patrickdcp77/lora-module-htcc-ab02/documentation/pcb_polyvalent_promini ou heltec_solaire_1bal_ds18b20_dht22/pcb_polyvalent_solaire_1bal_ds18b20_dht22 bis.png

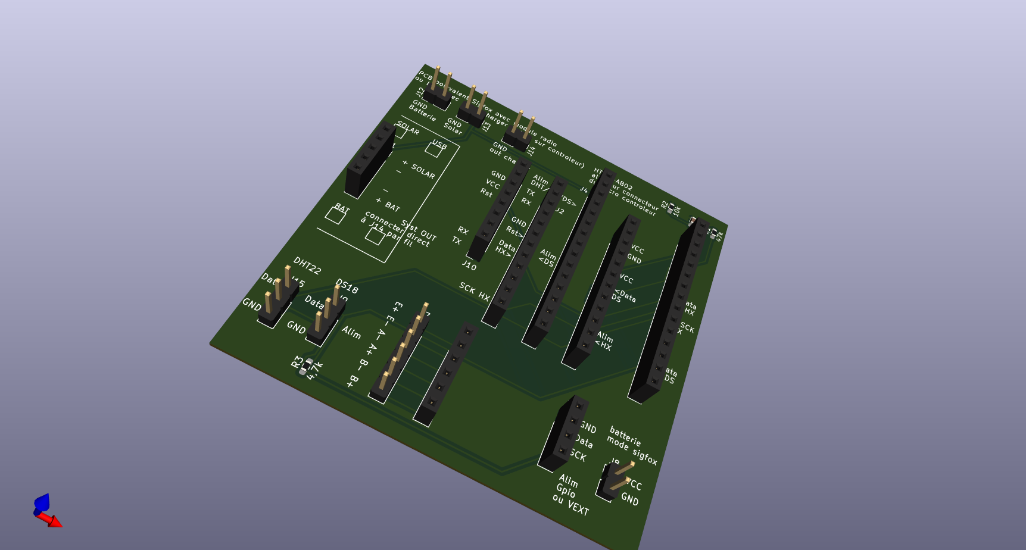
documentation/pcb_polyvalent_promini ou heltec_solaire_1bal_ds18b20_dht22/pcb_polyvalent_solaire_1bal_ds18b20_dht22 bis.png
