patrickdcp77/lora-module-htcc-ab02/(list of files, drawings)

Other design files:
documentation/pcb_polyvalent_promini ou heltec_solaire_1bal_ds18b20_dht22/pcb_polyvalent_solaire_1bal_ds18b20_dht22.dsn
