patrickdcp77/lora-module-htcc-ab02/documentation/pcb_polyvalent_promini ou heltec_solaire_1bal_ds18b20_dht22/pcb_polyvalent_solaire_1bal_ds18b20_dht22.kicad_pcb

## KiCad design documentation/pcb_polyvalent_promini ou heltec_solaire_1bal_ds18b20_dht22/pcb_polyvalent_solaire_1bal_ds18b20_dht22.kicad_pcb (2024-09-22)

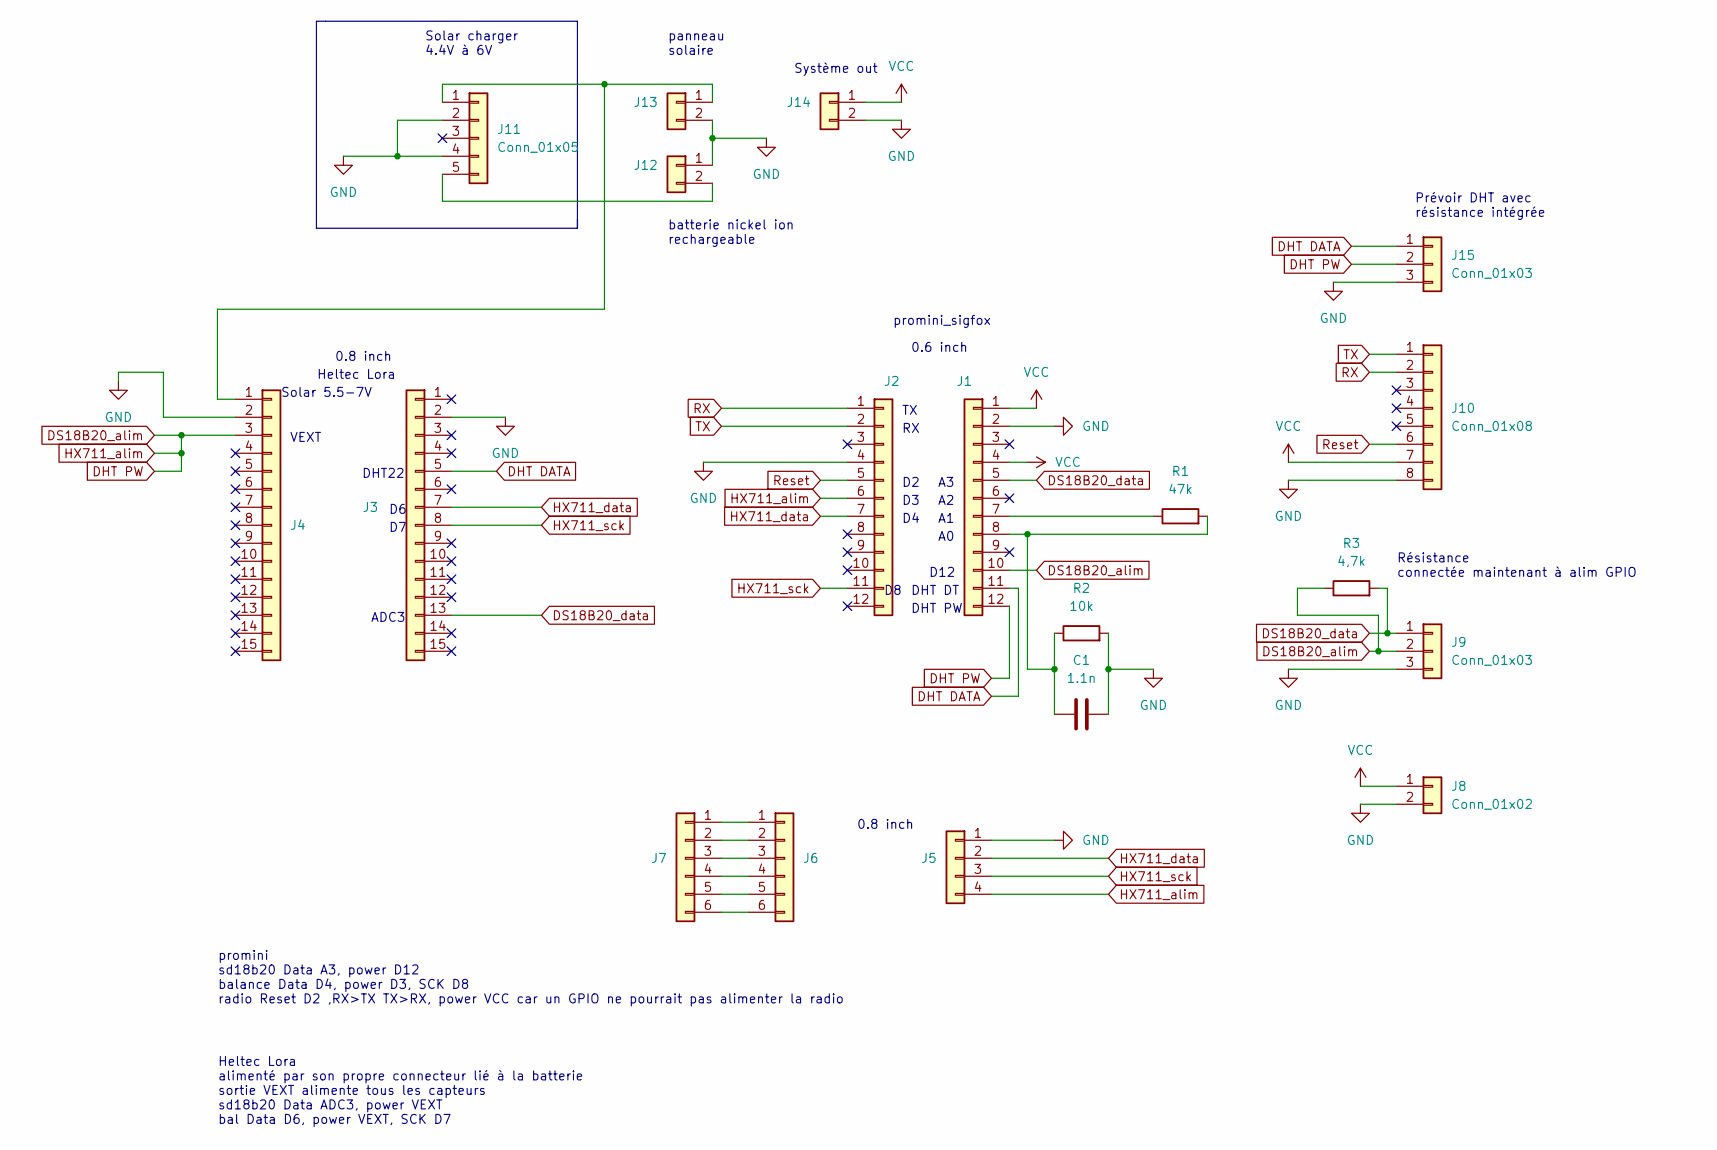
[picture p4: schematic pcb_polyvalent_solaire_1bal_ds18b20_dht22.kicad_sch]

Parts:
C1: 1.1n; C_0603_1608Metric_Pad1.08x0.95mm_HandSolder
J1, J2: Conn_01x12; PinSocket_1x12_P2.54mm_Vertical
J3, J4: Conn_01x15; PinSocket_1x15_P2.54mm_Vertical
J5: Conn_01x04; PinSocket_1x04_P2.54mm_Vertical
J6: Conn_01x06; PinSocket_1x06_P2.54mm_Vertical
J7: Conn_01x06; PinHeader_1x06_P2.54mm_Vertical
J8, J12, J13, J14: Conn_01x02; PinHeader_1x02_P2.54mm_Vertical
J9, J15: Conn_01x03; PinHeader_1x03_P2.54mm_Vertical
J10: Conn_01x08; PinSocket_1x08_P2.54mm_Vertical
J11: Conn_01x05; PinSocket_1x05_P2.54mm_Vertical
R1: 47k; R_0603_1608Metric_Pad0.98x0.95mm_HandSolder
R2: 10k; R_0603_1608Metric_Pad0.98x0.95mm_HandSolder
R3: 4,7k; R_0603_1608Metric_Pad0.98x0.95mm_HandSolder

Connections:
DHT DATA: J1.11, J3.5, J15.1
DHT PW: J1.10, J1.12, J2.6, J4.3, J5.4, J9.2, J15.2, R3.1
DS18B20_data: J1.5, J3.13, J9.1, R3.2
GND: C1.2, J1.2, J2.4, J3.2, J4.2, J5.1, J8.2, J9.3, J10.8, J11.2, J11.4, J12.1, J13.2, J14.2, J15.3, R2.2
HX711_data: J2.7, J3.7, J5.2
HX711_sck: J2.11, J3.8, J5.3
unnamed: J1.7, R1.1
unnamed: C1.1, J1.8, R1.2, R2.1
unnamed: J6.1, J7.1
unnamed: J6.2, J7.2
unnamed: J6.3, J7.3
unnamed: J6.4, J7.4
unnamed: J6.5, J7.5
unnamed: J6.6, J7.6
unnamed: J4.1, J11.1, J13.1
unnamed: J11.5, J12.2
RX: J2.1, J10.2
Reset: J2.5, J10.6
TX: J2.2, J10.1
VCC: J1.1, J1.4, J8.1, J10.7, J14.1

Notes on the sheet:
Solar charger 4.4V à 6V
Système out
Solar 5.5-7V
DHT DT
0.8 inch
Résistance connectée maintenant à alim GPIO
DHT22
Heltec Lora alimenté par son propre connecteur lié à la batterie sortie VEXT alimente tous les capteurs sd18b20 Data ADC3, power VEXT bal Data D6, power VEXT, SCK D7
Heltec Lora
DHT PW
promini_sigfox
ADC3
VEXT
D12
0.6 inch
batterie nickel ion rechargeable
Prévoir DHT avec résistance intégrée
panneau solaire
promini sd18b20 Data A3, power D12 balance Data D4, power D3, SCK D8 radio Reset D2 ,RX>TX TX>RX, power VCC car un GPIO ne pourrait pas alimenter la radio

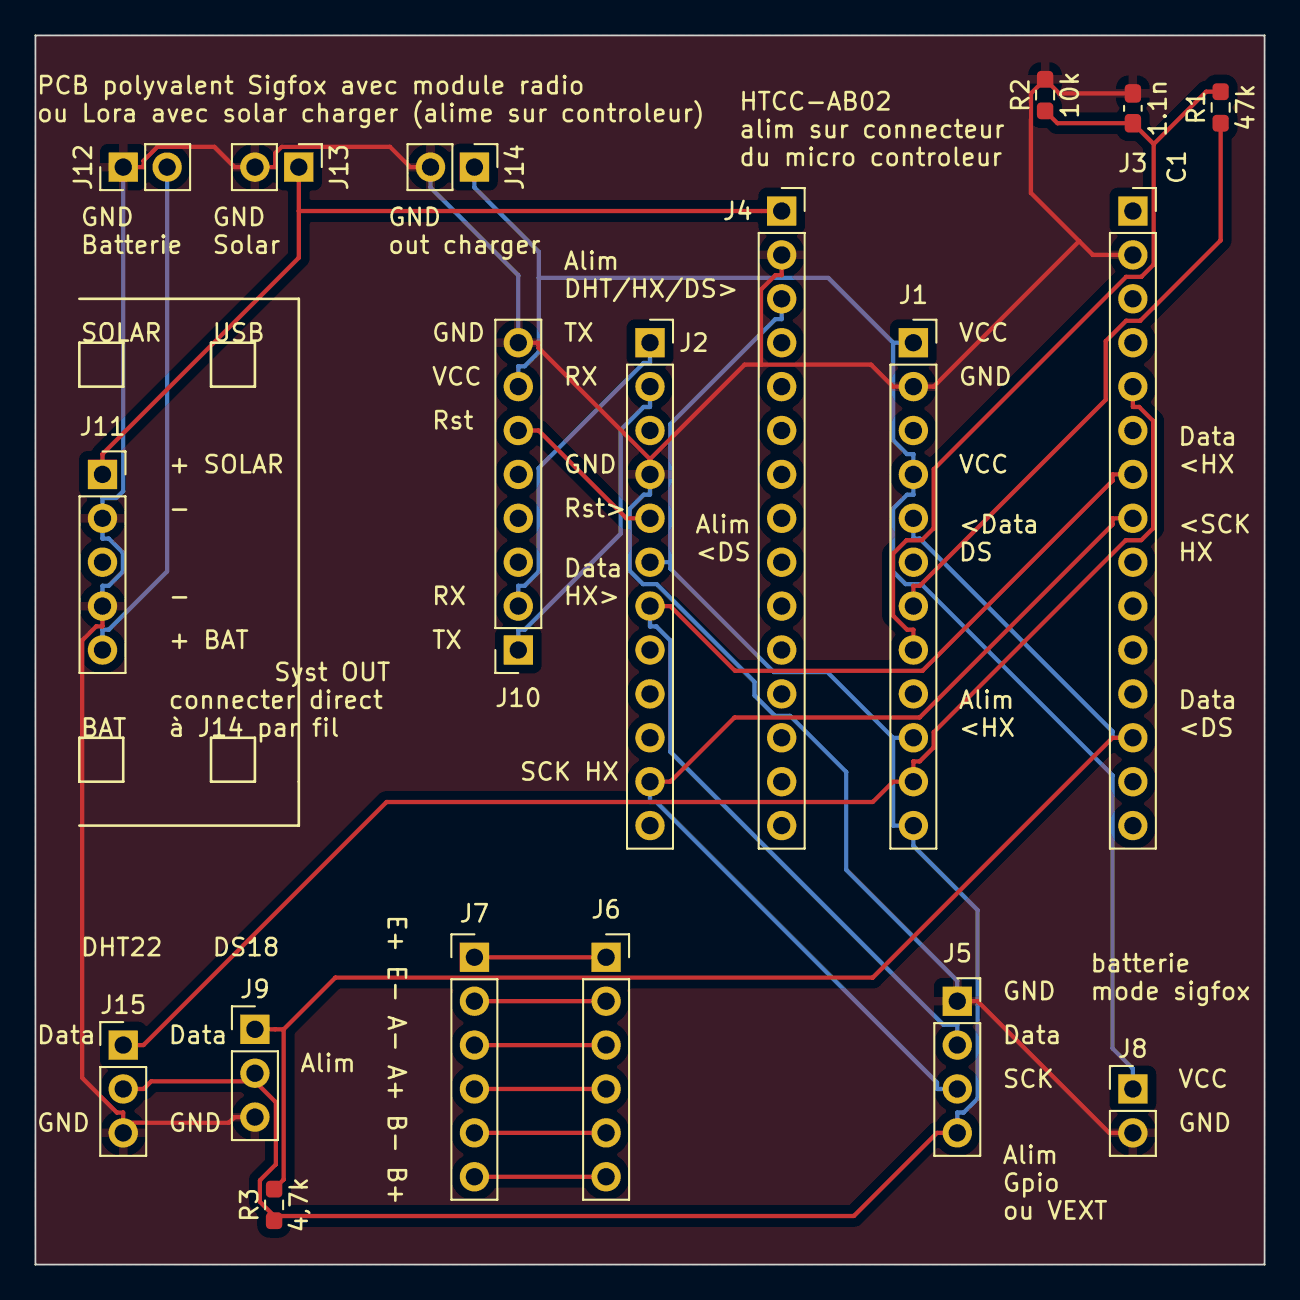
[picture p5: board pcb_polyvalent_solaire_1bal_ds18b20_dht22.kicad_pcb from above]

Board: 2 copper layers, 71.1 x 71.1 mm, 19 parts (0 on the bottom side), 20 nets.
