patrickdcp77/lora-module-htcc-ab02/LORA master 4bal dht22 et ds18b20.cpp

/*
ceci est basé sur le programme master de sylvain
le module est en mode OTAA
il est configuré pour émettre avec 20dbm
le nombre de cycle d'envoi est ici  uint32_t appTxDutyCycle = 15000; ici 15 secondes
il envoie pour l'instant la tension, température dht22 et humidité
l'envoi du poids est en cours de développement avec ce module
les clefs LORA sont préparées pour 4 devices déclarés dans LORAWAN TTN. Il faut décommenter celles que l'on a choisies

la lecture des capteur est demandée une fois au setup pour les balances puis dans le loop selon uint32_t appTxDutyCycle = 15000;
elle appelée avec prepareTxFrame( appPort );
puis les données sont envoyées avec LoRaWAN.send();
le format est l'octet dont le nombre est non limité à priori
des exemples sont disponibles via l'IDE arduino quand on a installé la bibliothèque de la carte cubcell HTCC-AB02 plus 

les balances et la sonde
largement commenté dans static void prepareTxFrame( uint8_t port )

alimentation des capteurs
on utilise la sortie VEXT : HIGH pas de tension     LOW tension sur VEXT
 */

/*
fonctionne correctement

pour les balances, cablage des connecteurs étanches
cordon crème et plat
noire   A,B+
rouge   E-
jaune   E+
vert    A,B-

correspondance avec les cables noirs étanches
vert    A,B+
noir    E-
rouge   E+
bleu    A,B-

cablage des balances vues en dessous (donc platine porte jauges retournée)
vue eu U inversé
    -------------------------
    |  E-              A,B+ |
    |                       |    
    |                       |
    |   A,B-            E+  |

fils noirs des jauges relient les jauges E- avec AB-  et AB+ avec E+
fils blancs des jauges telient E- avec AB+    et AB- avec E+



*/
#include "LoRaWan_APP.h" //https://github.com/mcci-catena/arduino-lorawan/
#include <Arduino.h>


//les température humidité
#include <DHT.h>
#include <DHT_U.h>
#define DHTPIN GPIO5    // Changer le pin sur lequel est branché le DHT
#define DHTTYPE DHT22 
DHT dht(DHTPIN, DHTTYPE); 

float humidite;
float temperature;

//les températures sonde DS18B20    EXterne au boitier
#include "OneWire.h"
#include "DallasTemperature.h"
OneWire oneWire(ADC3);
DallasTemperature ds(&oneWire);


//les balances.
//le module LORA a une sortie Vext sur laquelle on peut mettre l'alimentation des capteurs
//on met Vext à LOW pour alimenter et à HIGH pour couper l'alimentation
//par rapport au master de Sylvain, j'ai donc effacé la gestion de l'alimentation via une PIN spécialement dédiée
#include "HX711.h"
HX711 Hx711_N1;   
HX711 Hx711_N2;
HX711 Hx711_N3;
HX711 Hx711_N4;

#define PIN_HX711_N1_DATA_OUT GPIO6 // connexion au DATA
#define PIN_HX711_N1_SCK_AND_POWER_DOWN GPIO7// connexion à l'horloge SCK

float offset_HX711_N1_ChannelA;// pour Patrick et Sébastien on utilisera que le canal A+-
float offset_HX711_N1_ChannelB;//Sylvain utilise les 2 canaux pour mettre une barre de pesée par canal

boolean AUTODETECT_HX711_N2 = 1; // 0 = No 2nd HX711, autodetection of a 2nd HX711 is in Setup sequence will toggle to 1 if detected 

#define PIN_HX711_N2_DATA_OUT GPIO4
#define PIN_HX711_N2_SCK_AND_POWER_DOWN GPIO3

float offset_HX711_N2_ChannelA;
float offset_HX711_N2_ChannelB;

boolean AUTODETECT_HX711_N34 = 1 ; // 0 = No 3rd&4th  HX711, autodetection of a 3rd & 4th  HX711 is in Setup sequence will toggle to 1 if detected 

#define PIN_HX711_N3_DATA_OUT GPIO2
#define PIN_HX711_N3_SCK_AND_POWER_DOWN GPIO1

#define PIN_HX711_N4_DATA_OUT GPIO12
#define PIN_HX711_N4_SCK_AND_POWER_DOWN GPIO11

float offset_HX711_N3_ChannelA;
float offset_HX711_N4_ChannelA;

const unsigned int Weight_sensitivity = 4 ;
// DEBUG_MODE  mettre à zéro en mode normal pour moins consommer*************************
boolean DEBUG_MODE =1; // =1 or debug , then ALLOW BLINKING LED and statement on Serial Monitor throught SERIAL RX/TX UART0  


//  Header byte = 1st Byte transmitted int he Sigox Tram ( SIGFOX #01 )
// Bit 7 = Sigfog Debug Mode, =1 for SIGFOX DEBUG MODE
// Bit 6 = Solar Panel Luminosity, measured during software excution ( =0 Voltage solar panel < Voltage Battery, =1 > 
// Bit 5 = FUll Charging Battery status , measured during software excution
// Bit 4 = Charging on going, measured during software excution
// Bit 0 to 3 = Software version : 0000 = Debug Software, then 0001 = V1 ...
// Sensor readings may also be up to 2 seconds 'old' (its a very slow sensor)

byte header_byte = B00000000; //1 octet en entête non mis en place pour l'instant

//ceci est la partie qui règle les conditions d'émission radio du module. J'ai augmenté à 20db la puissance
//////////////////////////////////////Radio.SetTxConfig  dans le SETUP////////////
#define TX_OUTPUT_POWER                             14 ///14        // dBm

#define LORA_BANDWIDTH                              0         // [0: 125 kHz,
                                                              //  1: 250 kHz,
                                                              //  2: 500 kHz,
                                                              //  3: Reserved]
#define LORA_SPREADING_FACTOR                       9         // [SF7..SF12]
#define LORA_CODINGRATE                             1         // [1: 4/5,
                                                              //  2: 4/6,
                                                              //  3: 4/7,
                                                              //  4: 4/8]
#define LORA_PREAMBLE_LENGTH                      8         // Same for Tx and Rx
#define LORA_SYMBOL_TIMEOUT                         0         // Symbols
#define LORA_FIX_LENGTH_PAYLOAD_ON                  false
#define LORA_IQ_INVERSION_ON                        false
/////////////////////////////////////////////////////////////////////////////////



/* OTAA para c'est ce OTAA paramêtre qui est utilisé */

uint8_t appEui[] = { 0x00, 0x00, 0x00, 0x00, 0x00, 0x00, 0x00, 0x00 };

/*décommenter les modules à programmer */

//lora-01
uint8_t devEui[] = { 0x70, 0xB3, 0xD5, 0x7E, 0xD0, 0x05, 0xB1, 0xE8 };
uint8_t appKey[] = { 0x64, 0x15, 0x08, 0x32, 0x47, 0x90, 0x93, 0x43, 0x1D, 0x26, 0xB5, 0xFD, 0x34, 0xF8, 0xF0, 0xB8 };

//lora-02 GPS
//uint8_t devEui[] = { 0x70, 0xB3, 0xD5, 0x7E, 0xD0, 0x05, 0xB1, 0xE9 };
//uint8_t appKey[] = { 0x44, 0x9B, 0x5A, 0x40, 0x01, 0x94, 0x8A, 0x20, 0xE0, 0xD5, 0x89, 0x1B, 0xB6, 0x64, 0x7C, 0xCC };

//lora-03 GPS
//uint8_t devEui[] = { 0x70, 0xB3, 0xD5, 0x7E, 0xD0, 0x05, 0xB1, 0xEA };
//uint8_t appKey[] = { 0xDF, 0x6F, 0x66, 0x43, 0x25, 0x79, 0x56, 0x07, 0x11, 0x06, 0x0D, 0x5A, 0x39, 0x4B, 0x9C, 0x36 };

//lora-04
//uint8_t devEui[] = { 0x70, 0xB3, 0xD5, 0x7E, 0xD0, 0x05, 0xB1, 0xEB};
//uint8_t appKey[] = { 0x03, 0x6C, 0x0D, 0x88, 0x44, 0xDC, 0x68, 0xE4, 0xE5, 0xAE, 0xEE, 0x00, 0xCF, 0xA5, 0xFD, 0x67 };

// lora-05
//uint8_t devEui[] = { 0x70, 0xB3, 0xD5, 0x7E, 0xD0, 0x05, 0xB1, 0xE2 };
//uint8_t appKey[] = { 0x1E, 0xE9, 0x60, 0x7D, 0x71, 0x7A, 0x40, 0x17, 0x67, 0x10, 0x62, 0xFD, 0x02, 0xF3, 0xBB, 0x54 };

//bat //lora-06   lorabat
//uint8_t devEui[] = { 0x70, 0xB3, 0xD5, 0x7E, 0xD0, 0x05, 0xC4, 0xD3};
//uint8_t appKey[] = { 0x9C, 0xBB, 0x00, 0x03, 0xF8, 0xC6, 0xB9, 0xB2, 0x7B, 0x47, 0xAC, 0xEE, 0x38, 0xD2, 0x52, 0xE1  };

//lora-07
//uint8_t devEui[] = { 0x70, 0xB3, 0xD5, 0x7E, 0xD0, 0x05, 0xB1, 0xED };
//uint8_t appKey[] = { 0xF1, 0x3D, 0x66, 0x8A, 0x97, 0x04, 0xE7, 0x9D, 0x9F, 0xA6, 0x7A, 0x8B, 0x35, 0x9E, 0xF1, 0x24 };

//lora-08
//uint8_t devEui[] = { 0x70, 0xB3, 0xD5, 0x7E, 0xD0, 0x05, 0xB1, 0xE4 };
//uint8_t appKey[] = { 0x8D, 0x7D, 0xFE, 0x05, 0x32, 0x45, 0xAD, 0xAC, 0x3A, 0x40, 0x74, 0x04, 0x78, 0x85, 0xDE, 0xF0 };

//lora-09 GPS
//uint8_t devEui[] = { 0x70, 0xB3, 0xD5, 0x7E, 0xD0, 0x05, 0xB1, 0xEE };
//uint8_t appKey[] = { 0x1C, 0x92, 0x06, 0x95, 0xD4, 0x03, 0xF4, 0x34, 0xC6, 0x60, 0xB8, 0xC4, 0xFD, 0x90, 0xA2, 0x8D };

//lora-10
//uint8_t devEui[] = { 0x70, 0xB3, 0xD5, 0x7E, 0xD0, 0x05, 0xB1, 0xE7 };
//uint8_t appKey[] = { 0xAD, 0x07, 0x52, 0x8F, 0x33, 0x61, 0xBC, 0x9B, 0xDD, 0x28, 0x54, 0x93, 0x35, 0x4A, 0x35, 0x29 };



/* ABP para*/
uint8_t nwkSKey[] = { 0x15, 0xb1, 0xd0, 0xef, 0xa4, 0x63, 0xdf, 0xbe, 0x3d, 0x11, 0x18, 0x1e, 0x1e, 0xc7, 0xda,0x85 };
uint8_t appSKey[] = { 0xd7, 0x2c, 0x78, 0x75, 0x8c, 0xdc, 0xca, 0xbf, 0x55, 0xee, 0x4a, 0x77, 0x8d, 0x16, 0xef,0x67 };
uint32_t devAddr =  ( uint32_t )0x260B37FC;

/*LoraWan channelsmask, default channels 0-7*/ 
uint16_t userChannelsMask[6]={ 0x00FF,0x0000,0x0000,0x0000,0x0000,0x0000 };

/*LoraWan region, select in arduino IDE tools*/
LoRaMacRegion_t loraWanRegion = ACTIVE_REGION;

/*LoraWan Class, Class A and Class C are supported*/
DeviceClass_t  loraWanClass = LORAWAN_CLASS;

/*the application data transmission duty cycle.  value in [ms].*//////////////////////////////////////
uint32_t appTxDutyCycle = 900000;  //15000 donc 15sec;  900000 donc 15mn

/*OTAA or ABP*/
bool overTheAirActivation = LORAWAN_NETMODE;

/*ADR enable*/
bool loraWanAdr = LORAWAN_ADR;

/* set LORAWAN_Net_Reserve ON, the node could save the network info to flash, when node reset not need to join again */
bool keepNet = LORAWAN_NET_RESERVE;

/* Indicates if the node is sending confirmed or unconfirmed messages */
bool isTxConfirmed = LORAWAN_UPLINKMODE;

/* Application port */
uint8_t appPort = 2;
/*!
* Number of trials to transmit the frame, if the LoRaMAC layer did not
* receive an acknowledgment. The MAC performs a datarate adaptation,
* according to the LoRaWAN Specification V1.0.2, chapter 18.4, according
* to the following table:
*
* Transmission nb | Data Rate
* ----------------|-----------
* 1 (first)       | DR
* 2               | DR
* 3               | max(DR-1,0)
* 4               | max(DR-1,0)
* 5               | max(DR-2,0)
* 6               | max(DR-2,0)
* 7               | max(DR-3,0)
* 8               | max(DR-3,0)
*
* Note, that if NbTrials is set to 1 or 2, the MAC will not decrease
* the datarate, in case the LoRaMAC layer did not receive an acknowledgment
*/
uint8_t confirmedNbTrials = 4;


//*****************************
static void prepareTxFrame( uint8_t port )
{
  
/*
  //en miliVolts

  //appData[0] = (uint8_t)(batteryVoltage >> 8);//décalage de 8 bit vers la droite, 
  //4803  donne 0001001011000011 sur 16bit donc reste les 8 1ers bits 00010010  soit 12 hex
  //Serial.println(appData[4]);
  
  //appData[1] = (uint8_t)batteryVoltage;
  //4803  donne 0001001011000011 donc si uint_8  on prend donc 8bit de droite 11000011 soit C3 hex
  // quand on concatène 12C3 hex dans un convertisseur hexa vers décimal, cela donne 4803 mV au décodage de la trame LORA
  //Serial.println(appData[5]);

  //calcul pour la température
  //sur lorawan on obtient 00 74 hex
  //on concatène 00 et 74 , on convertit hexa vers décimal et on obtient 116 décimal
  //on reprend la formule de Sylvain  t_byte = (t + 35 )*2  donc partie entière de t=116/2 moins 35 degrés soit 23 degrés

  //calcul pour la pesée 
  //sur lorawan on obtient 04 9B hex  pour une donnée de 1179 correspondant à un poids de 13800gr
  //ou 1C E0 pour 7392  correspondant à 85700gr
  //le rapport entre 85700gr et 7392 est un multiplicateur de 11,6
  //quand on multiplie par 11,6 une mesure convertie en décimal, on obtient le poids réel en grammes
  */
  pinMode(Vext, OUTPUT);
  digitalWrite(Vext, LOW);// pour activer l'alimentation des capteurs branchés dur Vext
  delay(500);

  // DHT22 température et humidité locales


  Serial.println("DHTxx test!");

  delay(1000);
  dht.begin(); 
  
  delay(1000);//pour laisser le temps de montée de la sonde
  float h = dht.readHumidity();  
  delay(1000);
  // Read temperature as Celsius
  float t = dht.readTemperature();
  int8_t  t_byte = (t + 35 )*2;      //  à mieux commenter
  uint8_t h_byte = h*2;              // à mieux commenter

    
  Serial.print("Temperature: "); 
  Serial.print(t);
  Serial.print(" *C  ");
  Serial.print(t_byte,HEX);
  Serial.print(" Byte   ");
  Serial.print("Humidity : "); 
  Serial.print(h);
  Serial.print(" %\t  ");
  Serial.print(h_byte,HEX);
  Serial.println(" Byte   ");
                    
                    


  
  //sonde dc18b20 en externe******************************
  
  Serial.println("ds18b20 test!");

  delay(1000);  
  
  ds.begin();          // sonde activée

  delay(1000);
  ds.requestTemperatures();
  int tDs = ds.getTempCByIndex(0);
  int8_t  tDs_byte = (tDs + 35 )*2;

  
  Serial.print(tDs);
  Serial.println( " C  ");
  Serial.print(tDs_byte,HEX);
  Serial.println(" Byte   ");

  //la tension batterie
  uint16_t batteryVoltage = getBatteryVoltage();
  Serial.print(batteryVoltage);
  Serial.println( " mV ");


  //les balances*******************************************************
  
    float Sample_weight;
    
    Hx711_N1.begin(PIN_HX711_N1_DATA_OUT,PIN_HX711_N1_SCK_AND_POWER_DOWN,64 );
    Sample_weight = Hx711_N1.get_units();                                          // For nothing library problem...
    Sample_weight = (offset_HX711_N1_ChannelA - Hx711_N1.get_units())/256*Weight_sensitivity;

    if (Sample_weight < 0) { 
        Sample_weight =0; 
        }
    else { 
       if (Sample_weight > 65535) { 
           Sample_weight = 65535; 
           }
       }

    unsigned int Weight_HX711_N1_Channel_A = Sample_weight;
 
    Hx711_N1.begin(PIN_HX711_N1_DATA_OUT,PIN_HX711_N1_SCK_AND_POWER_DOWN,32 );
    Sample_weight = Hx711_N1.get_units();                                          // For nothing library problem...
    Sample_weight = (offset_HX711_N1_ChannelB - Hx711_N1.get_units())/128*Weight_sensitivity;

    if (Sample_weight < 0) {
        Sample_weight =0; 
        }
        else { 
        if (Sample_weight > 65535) { 
            Sample_weight = 65535; 
            }
        }
    
    unsigned int Weight_HX711_N1_Channel_B = Sample_weight;

 
    unsigned int Weight_HX711_N2_Channel_A;
    unsigned int Weight_HX711_N2_Channel_B;

    if (AUTODETECT_HX711_N2) {
                                Hx711_N2.begin(PIN_HX711_N2_DATA_OUT,PIN_HX711_N2_SCK_AND_POWER_DOWN,64 );
                                Sample_weight = Hx711_N2.get_units();                                          // For nothing library problem...
                                Sample_weight = (offset_HX711_N2_ChannelA - Hx711_N2.get_units())/256*Weight_sensitivity;

                                if (Sample_weight < 0) { 
                                    Sample_weight =0; 
                                    }
                                else { 
                                    if (Sample_weight > 65535) { 
                                                            Sample_weight = 65535; 
                                                            }
                                    }

                                Weight_HX711_N2_Channel_A = Sample_weight;

                                Hx711_N2.begin(PIN_HX711_N2_DATA_OUT,PIN_HX711_N2_SCK_AND_POWER_DOWN,32 );
                                Sample_weight = Hx711_N2.get_units();                                          // For nothing library problem...
                                Sample_weight = (offset_HX711_N2_ChannelB - Hx711_N2.get_units())/128*Weight_sensitivity;

                                if (Sample_weight < 0) {
                                    Sample_weight =0; 
                                    }
                                    else { 
                                    if (Sample_weight > 65535) { 
                                                                Sample_weight = 65535; 
                                                                }
                                    }
                                
                                Weight_HX711_N2_Channel_B = Sample_weight;
                                
                                
                            }

    
    unsigned int Weight_HX711_N3_Channel_A;
    unsigned int Weight_HX711_N4_Channel_A;


    if (AUTODETECT_HX711_N34) {
                                Hx711_N3.begin(PIN_HX711_N3_DATA_OUT,PIN_HX711_N3_SCK_AND_POWER_DOWN,64 );
                                Sample_weight = Hx711_N3.get_units();                                          // For nothing library problem...
                                Sample_weight = (offset_HX711_N3_ChannelA - Hx711_N3.get_units())/256*Weight_sensitivity;

                                if (Sample_weight < 0) { 
                                    Sample_weight =0; 
                                    }
                                else { 
                                    if (Sample_weight > 65535) { 
                                                            Sample_weight = 65535; 
                                                            }
                                    }

                                Weight_HX711_N3_Channel_A = Sample_weight;

                                

                                Hx711_N4.begin(PIN_HX711_N4_DATA_OUT,PIN_HX711_N4_SCK_AND_POWER_DOWN,64 );
                                Sample_weight = Hx711_N4.get_units();                                          // For nothing library problem...
                                Sample_weight = (offset_HX711_N4_ChannelA - Hx711_N4.get_units())/256*Weight_sensitivity;

                                if (Sample_weight < 0) {
                                    Sample_weight =0; 
                                    }
                                    else { 
                                    if (Sample_weight > 65535) { 
                                                                Sample_weight = 65535; 
                                                                }
                                    }
                                
                                Weight_HX711_N4_Channel_A = Sample_weight;

                                //digitalWrite(POWER_PIN_HX711_N3_DATA_OUT,LOW);
                                //digitalWrite(POWER_PIN_HX711_N4_DATA_OUT,LOW);

                            }


    //digitalWrite(POWER_PIN_HX711_N1_DATA_OUT,LOW);
       //if (AUTODETECT_HX711_N2) { digitalWrite(POWER_PIN_HX711_N2_DATA_OUT,LOW); }


    if (DEBUG_MODE) {  
                        Serial.print("Weight N1 Channel A : ");
   
                        Serial.print(Weight_HX711_N1_Channel_A,DEC);
                        Serial.print(" "); 
                        Serial.print(Weight_HX711_N1_Channel_A,HEX);
                        Serial.print(" "); 
                        Serial.print(Weight_HX711_N1_Channel_A,BIN);
                        Serial.print(" "); 

                        Serial.print("Weight N1 Channel B : ");

                        Serial.print(Weight_HX711_N1_Channel_B,DEC);
                        Serial.print(" "); 
                        Serial.print(Weight_HX711_N1_Channel_B,HEX);
                        Serial.print(" "); 
                        Serial.print(Weight_HX711_N1_Channel_B,BIN);
                        Serial.print(" ");
   
                        Serial.println();

                        if (AUTODETECT_HX711_N2) {
                                                    Serial.print("Weight N2 Channel A : ");
   
                                                    Serial.print(Weight_HX711_N2_Channel_A,DEC);
                                                    Serial.print(" "); 
                                                    Serial.print(Weight_HX711_N2_Channel_A,HEX);
                                                    Serial.print(" "); 
                                                    Serial.print(Weight_HX711_N2_Channel_A,BIN);
                                                    Serial.print(" "); 

                                                    Serial.print("Weight N2 Channel B : ");

                                                    Serial.print(Weight_HX711_N2_Channel_B,DEC);
                                                    Serial.print(" "); 
                                                    Serial.print(Weight_HX711_N2_Channel_B,HEX);
                                                    Serial.print(" "); 
                                                    Serial.print(Weight_HX711_N2_Channel_B,BIN);
                                                    Serial.print(" ");
                            
                                                    Serial.println();

                                                    }

                        if (AUTODETECT_HX711_N34) {
                                                    Serial.print("Weight N3 Channel A : ");
   
                                                    Serial.print(Weight_HX711_N3_Channel_A,DEC);
                                                    Serial.print(" "); 
                                                    Serial.print(Weight_HX711_N3_Channel_A,HEX);
                                                    Serial.print(" "); 
                                                    Serial.print(Weight_HX711_N3_Channel_A,BIN);
                                                    Serial.print(" "); 

                                                    Serial.print("Weight N4 Channel A : ");

                                                    Serial.print(Weight_HX711_N4_Channel_A,DEC);
                                                    Serial.print(" "); 
                                                    Serial.print(Weight_HX711_N4_Channel_A,HEX);
                                                    Serial.print(" "); 
                                                    Serial.print(Weight_HX711_N4_Channel_A,BIN);
                                                    Serial.print(" ");
                            
                                                    Serial.println();

                                                    }


                    }



  
    

    //en miliVolts

    //appData[0] = (uint8_t)(batteryVoltage >> 8);//décalage de 8 bit vers la droite, 
    //4803  donne 0001001011000011 sur 16bit donc reste les 8 1ers bits 00010010  soit 12 hex
    //Serial.println(appData[4]);
    
    //appData[1] = (uint8_t)batteryVoltage;
    //4803  donne 0001001011000011 donc si uint_8  on prend donc 8bit de droite 11000011 soit C3 hex
    // quand on concatène 12C3 hex dans un convertisseur hexa vers décimal, cela donne 4803 mV au décodage de la trame LORA
    //Serial.println(appData[5]);

    //calcul pour la température
    //sur lorawan on obtient 00 74 hex
    //on concatène 00 et 74 , on convertit hexa vers décimal et on obtient 116 décimal
    //on reprend la formule de Sylvain  t_byte = (t + 35 )*2  donc partie entière de t=116/2 moins 35 degrés soit 23 degrés

    //calcul pour l'humidité
    //sur lorawan on obtient 00 7F hex
    //on concatène 00 et 7F , on convertit hexa vers décimal et on obtient 127 décimal
    //on reprend la formule de Sylvain h_byte = h*2 donc partie entière de h=127/2 soit 63%

    //calcul pour la pesée 
    //sur lorawan on obtient 04 9B hex  pour une donnée de 1179 correspondant à un poids de 13800gr
    //ou 1C E0 pour 7392  correspondant à 85700gr
    //le rapport entre 85700gr et 7392 est un multiplicateur de 11,6
    //quand on multiplie par 11,6 une mesure convertie en décimal, on obtient le poids réel en grammes
  
  appDataSize = 16;// nombre total d'octets de la trame envoyée
  //et à changer selon le nombre de balances et capteurs

  appData[0] = (uint8_t)(batteryVoltage>>8);
  appData[1] = (uint8_t)batteryVoltage;


  appData[2] = (uint8_t)(t_byte>>8);
  appData[3] = (uint8_t)t_byte;


  appData[4] = (uint8_t)(h_byte>>8);
  appData[5] = (uint8_t)h_byte;

  appData[6] = (uint8_t)(tDs_byte>>8);
  appData[7] = (uint8_t)tDs_byte;


  appData[8] = (uint8_t)(Weight_HX711_N1_Channel_A>>8);
  appData[9] = (uint8_t)Weight_HX711_N1_Channel_A;

  appData[10] = (uint8_t)(Weight_HX711_N2_Channel_A>>8);
  appData[11] = (uint8_t)Weight_HX711_N2_Channel_A;

  appData[12] = (uint8_t)(Weight_HX711_N3_Channel_A>>8);
  appData[13] = (uint8_t)Weight_HX711_N3_Channel_A;

  appData[14] = (uint8_t)(Weight_HX711_N4_Channel_A>>8);
  appData[15] = (uint8_t)Weight_HX711_N4_Channel_A;

  digitalWrite(Vext, HIGH);//HIGH une fois les mesures faites, couper alimentation sortie Vext 3V3 par économie de mA

}

void setup()
{

  Serial.begin(9600);

  pinMode(Vext, OUTPUT);
  digitalWrite(Vext, LOW);//alimentation de la sonde est valide pour permettre initialisation de la sonde
  delay(1000);//on laisse un temps de montée pour la sonde


  if (DEBUG_MODE) {   
                        Serial.print("SETUP DONE");
                        Serial.println();
                        
                }
  Serial.print("cycle d'envoi des données en ms  ");
  Serial.print(appTxDutyCycle);
  Serial.println();
  
  #if(AT_SUPPORT)//ne pas oublier ce module???
  enableAt();
  #endif
  deviceState = DEVICE_STATE_INIT;
  LoRaWAN.ifskipjoin();
  
  
  
  //initialisation et détection des balances

  
  float Sample_weight;

  //////////dans le SETUP on calcule une bonne fois l'offset en mesurant la balance à VIDE après un RESET

  Hx711_N1.begin(PIN_HX711_N1_DATA_OUT,PIN_HX711_N1_SCK_AND_POWER_DOWN,64 );
  Sample_weight = Hx711_N1.get_units();
  offset_HX711_N1_ChannelA = Hx711_N1.get_units();

  Hx711_N1.begin(PIN_HX711_N1_DATA_OUT,PIN_HX711_N1_SCK_AND_POWER_DOWN,32 );
  Sample_weight = Hx711_N1.get_units();
  offset_HX711_N1_ChannelB = Hx711_N1.get_units();

  Hx711_N2.begin(PIN_HX711_N2_DATA_OUT,PIN_HX711_N2_SCK_AND_POWER_DOWN,64 );
  Sample_weight = Hx711_N2.get_units();
  offset_HX711_N2_ChannelA = Hx711_N2.get_units();

  Hx711_N2.begin(PIN_HX711_N2_DATA_OUT,PIN_HX711_N2_SCK_AND_POWER_DOWN,32 );
  Sample_weight = Hx711_N2.get_units();
  offset_HX711_N2_ChannelB = Hx711_N2.get_units();

  if ((offset_HX711_N2_ChannelA!=0) & (offset_HX711_N2_ChannelA!=0)) 
  { AUTODETECT_HX711_N2 = 1 ;}



  Hx711_N3.begin(PIN_HX711_N3_DATA_OUT,PIN_HX711_N3_SCK_AND_POWER_DOWN,64 );
  Sample_weight = Hx711_N3.get_units();
  offset_HX711_N3_ChannelA = Hx711_N3.get_units();

  Hx711_N4.begin(PIN_HX711_N4_DATA_OUT,PIN_HX711_N4_SCK_AND_POWER_DOWN,64 );
  Sample_weight = Hx711_N4.get_units();
  offset_HX711_N4_ChannelA = Hx711_N4.get_units();

  if ((offset_HX711_N3_ChannelA!=0) & (offset_HX711_N4_ChannelA!=0)) 
  { AUTODETECT_HX711_N34 = 1 ;}

  if (DEBUG_MODE) {  
                          Serial.print("Offset N1 Channel A : ");
                          Serial.print(offset_HX711_N1_ChannelA);

                          Serial.print(" Offset N1 Channel B : ");
                          Serial.print(offset_HX711_N1_ChannelB);

                          Serial.println();
                          
                          
                          Serial.print("Offset N2 Channel A : ");
                          Serial.print(offset_HX711_N2_ChannelA);

                          Serial.print(" Offset N2 Channel B : ");
                          Serial.print(offset_HX711_N2_ChannelB);

                          Serial.print(" AUTO DETECT N2 : ");
                          Serial.print(AUTODETECT_HX711_N2);

                          Serial.println();              
                        
                        
                          Serial.print("Offset N3 Channel A : ");
                          Serial.print(offset_HX711_N3_ChannelA);

                          Serial.print(" Offset N4 Channel A : ");
                          Serial.print(offset_HX711_N4_ChannelA);

                          Serial.print(" AUTO DETECT N3&N4 : ");
                          Serial.print(AUTODETECT_HX711_N34);

                          Serial.println();
                          
                          Serial.flush() ;

                  }

  prepareTxFrame( appPort ); 
  ////////////////////////////////////////////////////////////////////////////////////
  /*
   paramêtres de puissance émission à 20db PW maxi 110mA via constructeur voir #define TX_OUTPUT_POWER 
  */
  
  Radio.SetTxConfig( MODEM_LORA, TX_OUTPUT_POWER, 0, LORA_BANDWIDTH,
                                   LORA_SPREADING_FACTOR, LORA_CODINGRATE,
                                   LORA_PREAMBLE_LENGTH, LORA_FIX_LENGTH_PAYLOAD_ON,
                                   true, 0, 0, LORA_IQ_INVERSION_ON, 3000 ); 
                                   
  /////////////////////////////////////////////////////////////////////////////////////
  

   digitalWrite(Vext, HIGH);
}

void loop()
{

switch( deviceState )
  {
    case DEVICE_STATE_INIT:
    {
#if(LORAWAN_DEVEUI_AUTO)
      LoRaWAN.generateDeveuiByChipID();
#endif
#if(AT_SUPPORT)
      getDevParam();
#endif
      printDevParam();
      LoRaWAN.init(loraWanClass,loraWanRegion);
      deviceState = DEVICE_STATE_JOIN;
      break;
    }
    case DEVICE_STATE_JOIN:
    {
      LoRaWAN.join();
      break;
    }
    case DEVICE_STATE_SEND:
    {
      prepareTxFrame( appPort );
      LoRaWAN.send();
      
      deviceState = DEVICE_STATE_CYCLE;
      break;
    }
    case DEVICE_STATE_CYCLE:
    {
      // Schedule next packet transmission
      txDutyCycleTime = appTxDutyCycle + randr( 0, APP_TX_DUTYCYCLE_RND );
      LoRaWAN.cycle(txDutyCycleTime);
      deviceState = DEVICE_STATE_SLEEP;
      break;
    }
    case DEVICE_STATE_SLEEP:
    {
      LoRaWAN.sleep();
      break;
    }
    default:
    {
      deviceState = DEVICE_STATE_INIT;
      break;
    }
  }



  
}
