patrickdcp77/lora-module-htcc-ab02/(commit log)

2023-07-28 soft vérifié avec la boite lora-10
2024-09-22 mise à jour lora-01 avec la sonde seule et soft GPT
2024-09-22 ajout d'une documentation sur la fabrication du PCB polyvalent sigfox lora
    [pcb_polyvalent_solaire_1bal_ds18b20_dht22.dsn, pcb_polyvalent_solaire_1bal_ds18b20_dht22.kicad_pcb, pcb_polyvalent_solaire_1bal_ds18b20_dht22.kicad_sch]
2024-09-22 changement commentaire dans schéma
    [pcb_polyvalent_solaire_1bal_ds18b20_dht22.kicad_sch]
2024-09-22 change dossier kicad en version 8
    [pcb_polyvalent_solaire_1bal_ds18b20_dht22.kicad_sch]
2024-09-22 ajout vue 3D PCB
